baranusluel/square-on/README.md

# square-on
Open-source version of Square Off, a chess board robot

Documentation: https://baranusluel.com/square-on/

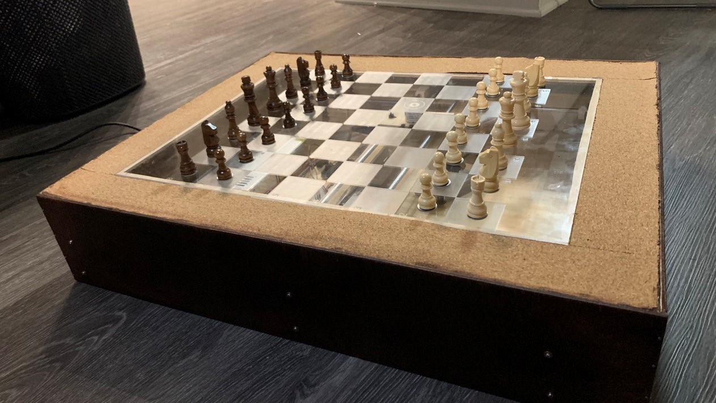
[picture p1: docs/assets/squareon.jpg]
Square On
