baranusluel/square-on/docs/assets/image20.jpg

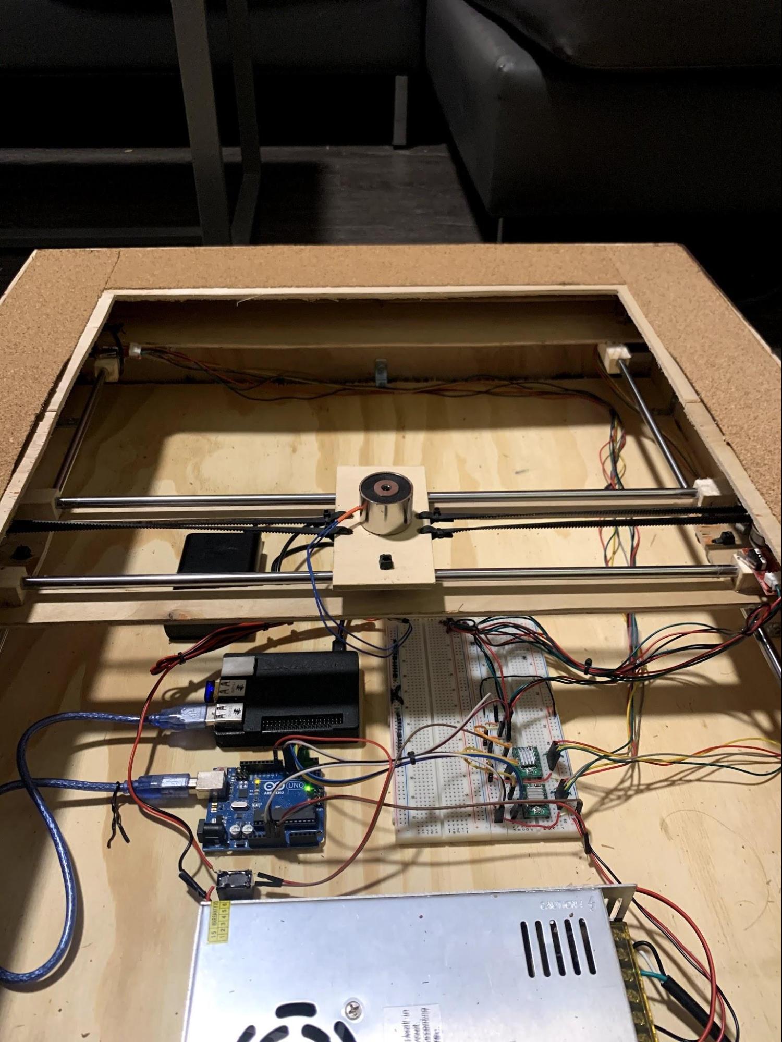
docs/assets/image20.jpg
