baranusluel/square-on/cad/assembly.SLDASM

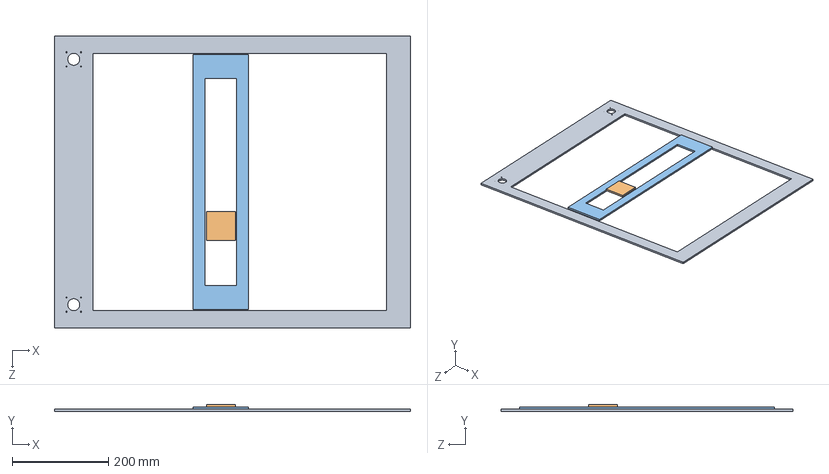
[picture p25: CAD file, 2020-11-13, last stored version]
cad/assembly.SLDASM
740.0 x 15.0 x 608.0 mm
robot-baseplate
robot-x-carriage
robot-y-carriage
