baranusluel/square-on/cad/robot-y-carriage.SLDPRT

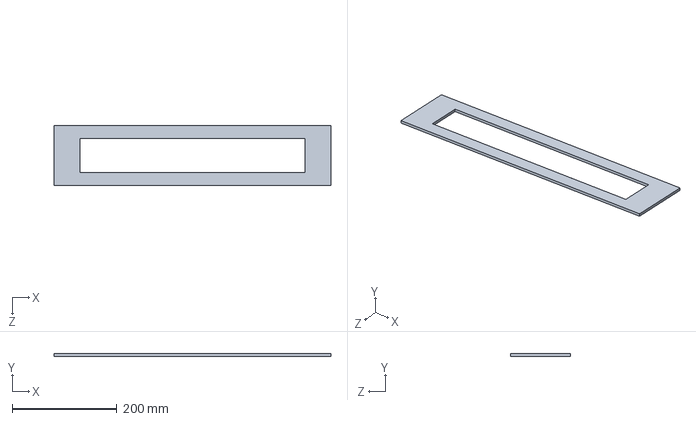
[picture p26: CAD file, 2020-11-13, last stored version]
cad/robot-y-carriage.SLDPRT
530.0 x 5.00 x 115.0 mm
