baranusluel/square-on/cad/smooth-rod-500mm.SLDPRT

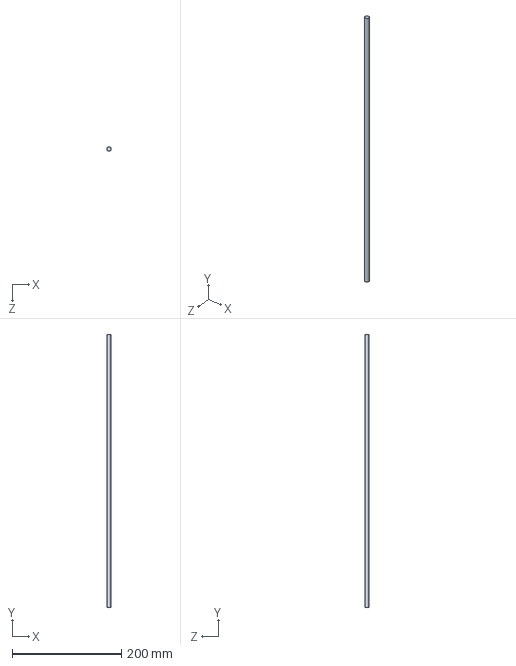
[picture p27: CAD file, 2020-11-13, last stored version]
cad/smooth-rod-500mm.SLDPRT
8.00 x 500.0 x 8.00 mm
