baranusluel/square-on/cad/smooth-rod-600mm.SLDPRT

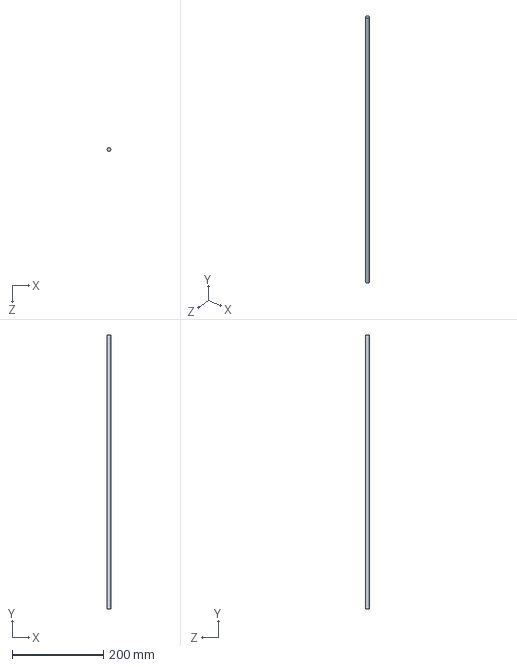
[picture p28: CAD file, 2020-11-13, last stored version]
cad/smooth-rod-600mm.SLDPRT
8.00 x 600.0 x 8.00 mm
