baranusluel/square-on/cad/robot-baseplate.SLDPRT

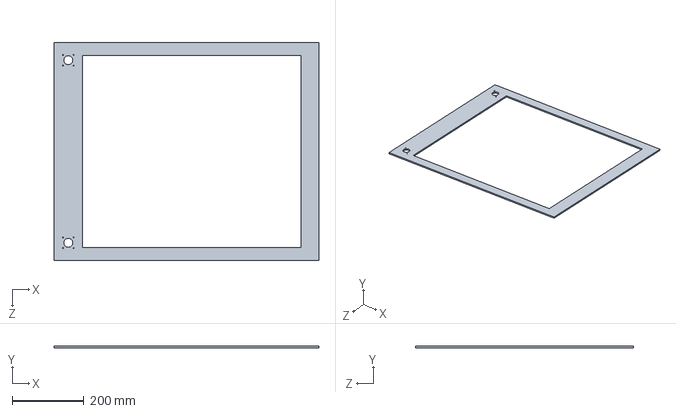
[picture p29: CAD file, 2020-11-13, last stored version]
cad/robot-baseplate.SLDPRT
740.0 x 5.00 x 608.0 mm
