baranusluel/square-on/cad/robot-x-carriage.SLDPRT

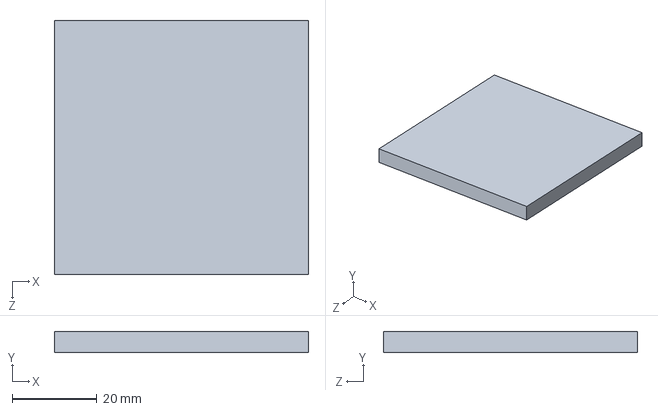
[picture p30: CAD file, 2020-11-13, last stored version]
cad/robot-x-carriage.SLDPRT
60.0 x 5.00 x 60.0 mm
