baranusluel/square-on/(commit log)

2020-11-13 Add Solidworks CAD of first parts
    [assembly.SLDASM, robot-baseplate.SLDPRT, robot-x-carriage.SLDPRT, robot-y-carriage.SLDPRT, smooth-rod-500mm.SLDPRT, smooth-rod-600mm.SLDPRT]
2020-11-21 Add chess board design for laser engraving
2020-11-29 Create Arduino controller for testing
2020-12-02 Rename Arduino code
2020-12-03 Copy arduino testbench sketch
2020-12-03 Add board state analysis to controller
2020-12-03 Adjust motor speed in testbench
2020-12-03 Add controller support for moving pieces according to board state
2020-12-04 Add special cases for overshooting, knight movement and capturing offsets
    [arduino-controller.ino]
2020-12-04 Fix BOM table
2020-12-04 Remove incomplete cad files
    [assembly.SLDASM, robot-baseplate.SLDPRT, robot-x-carriage.SLDPRT, robot-y-carriage.SLDPRT, smooth-rod-500mm.SLDPRT, smooth-rod-600mm.SLDPRT]
